swarazore23/Swara_Zore/Project Documents/4. Learnings & Reflections_SwaraZore.pdf

# Learnings & Reflections Document

### 1. Team Reflection

The team worked well because we balanced each other. One person brought optimism and energy, while the other brought practicality and structure. At different moments, one took the lead while the other supported. Consistent effort from both sides helped the project move forward. What worked well was our natural division of tasks, regular communication, and ability to support each other during stressful moments. We stayed committed and kept working steadily.
Better emotional handling could improve teamwork. If one person panicked, the other often had to carry more pressure. Managing stress better would make the process smoother for both members.

### 2. Technical Reflection

Loose wire connections were one of the biggest challenges, as they repeatedly caused circuits to stop working. Sensors and components also needed multiple rounds of testing before working properly.
I learned the importance of neat wiring, careful testing, and building systems step by step. I also understood how small coding errors can affect the whole project.
We often had to redo circuits and test components individually to find faults. Repeating tests, correcting errors, and improving the code taught us patience and problem-solving.

### 3. Design Reflection

The final outcome was fairly close to our original idea. Although some features were simplified due to time and material limits, it still delivered the intended escape room experience.
With more time, I would improve the finishing, hide wires better, add smoother mechanisms, and make the puzzles more immersive and refined.

### 4. Personal Reflection

I learned that patience and consistency are the keys to completing any project. Progress felt slow many times, but showing up regularly and continuing to work made all the difference. I also realized that small victories feel the most special when they come after a lot of effort. Another important lesson was understanding how team dynamics can either strengthen a project or weaken it. I also understood the fine line between optimism and delusion. It is important to stay hopeful, but being practical matters just as much.

I struggled with recurring technical issues, including loose wiring, code errors, and components failing during testing. Managing time pressure while maintaining quality was also difficult. At times, balancing ambitious ideas with realistic execution was a challenge.

I am proud that we stayed committed despite setbacks and completed a functional, interactive escape room model. I am also proud that we were able to combine storytelling, electronics, puzzles, and teamwork into one final experience.
