swarazore23/Swara_Zore/Software Details/Software Details_EscapeRoom.pdf

# Software Documentation

### 1. Software Overview

What does the software do?

The escape room software runs entirely on two ESP32 microcontrollers using MicroPython. There is no mobile app or external communication involved. Each ESP32 independently manages its puzzle logic — reading sensor inputs, controlling LEDs, operating a servo motor, and triggering a buzzer. When a player completes the puzzle correctly, the system gives a visual and/or audio confirmation.

- Room 1 has its own dedicated ESP32. It detects whether a wire is correctly connected and waits for the player to press a button to confirm the puzzle is solved. LEDs provide feedback throughout.
- Rooms 2 and 3 share a single ESP32 and run the same code. The player must trigger a scan input followed by an IR sensor. This opens a servo-controlled door, starts a blinking alarm, and waits for the player to press a stop button to complete the puzzle.

Platforms used:

- MicroPython (programming language for ESP32)
- 2x ESP32 microcontrollers (one for Room 1, one shared by Room 2 & 3)
- Thonny IDE (used to write and upload code)
- No app, no Bluetooth, no Wi-Fi — fully offline and local

### 2. System Logic

Room 1 — Wire Detection Puzzle (ESP32 #1)

1. ESP32 powers on — yellow LED turns on to show system is ready
2. System continuously checks the wire input pin
3. Player connects the correct wire
4. Wire input pin goes HIGH — all three LEDs (led1, led2, led3) turn on

5. Player presses the button
6. Button pin goes LOW — green LED (ledG) turns on, confirming puzzle solved
7. System continues running (LEDs stay on)

Room 2 & 3 — Scan, IR & Servo Puzzle (ESP32 #2, shared)

1. ESP32 powers on — led1 turns on to show system is ready
2. System continuously checks the scan input pin
3. Player performs the scan action (triggers scan input HIGH)
4. led2 and led3 turn on — scan confirmed
5. System now waits for IR sensor to be triggered
6. Player moves in front of the IR sensor (IR pin goes LOW)
7. Servo opens (duty = 40) — door unlocks
8. Alarm loop starts — led4 and buzzer blink repeatedly
9. After 15 seconds — servo automatically closes (duty = 115)
10. Player presses the stop button
11. Buzzer turns off, led1 turns off, green LED turns on — puzzle solved

### 3. Flowchart

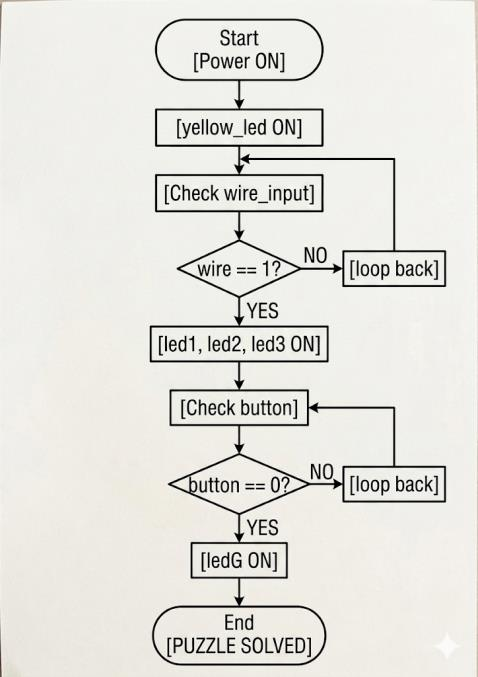
[picture p7: figure]
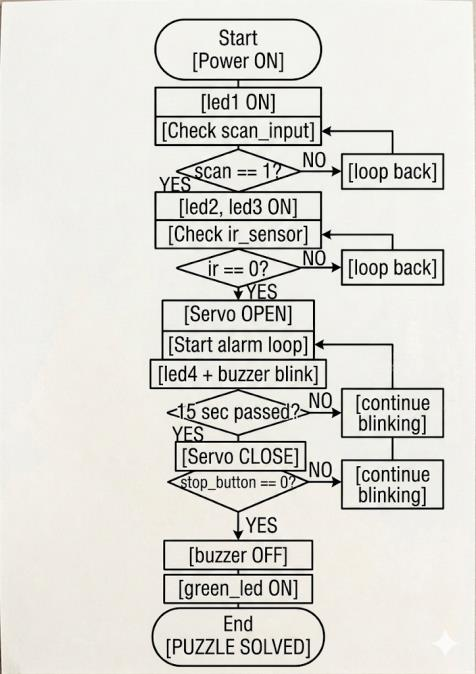
[picture p8: figure]

Room 1 - | Room 2-
