swarazore23/Swara_Zore/Software Details/final codes with versions_EscapeRoom.pdf

Room 1 -Version 1 — Basic Prototype

Goal of this version: Get the core logic working — detect the wire, light an LED, detect the button press. No concern for noise or stability yet.

This was our very first attempt. We set up the minimum number of pins needed and got the logic running in a tight while loop. At this stage we did not use pull-up resistors, which later turned out to be a problem.

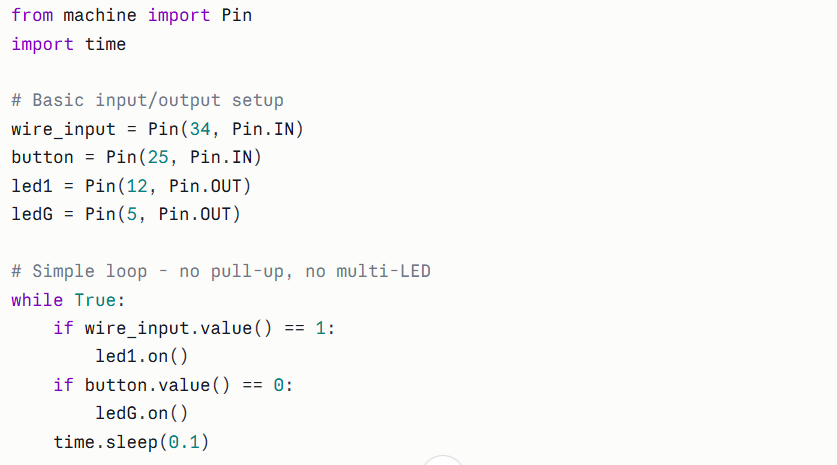
[picture p9: figure]

Problems noticed: Without PULL_UP resistors, the input pins picked up floating noise. The wire_input would randomly trigger even with nothing connected. We also only had one LED, giving very little visual feedback to the player.

Version 2 — Intermediate Improvements

Goal of this version: Added Pin.PULL_UP to both inputs to eliminate floating signal noise. Expanded to 3 wire-trigger LEDs and added a yellow 'system on' LED.

After testing Version 1, the wire input was randomly triggering due to floating voltage on the pin. We added internal pull-up resistors, which solved this immediately. We also added more LEDs so the puzzle had a clearer visual response — three LEDs lighting up together is much more satisfying for the player than just one.

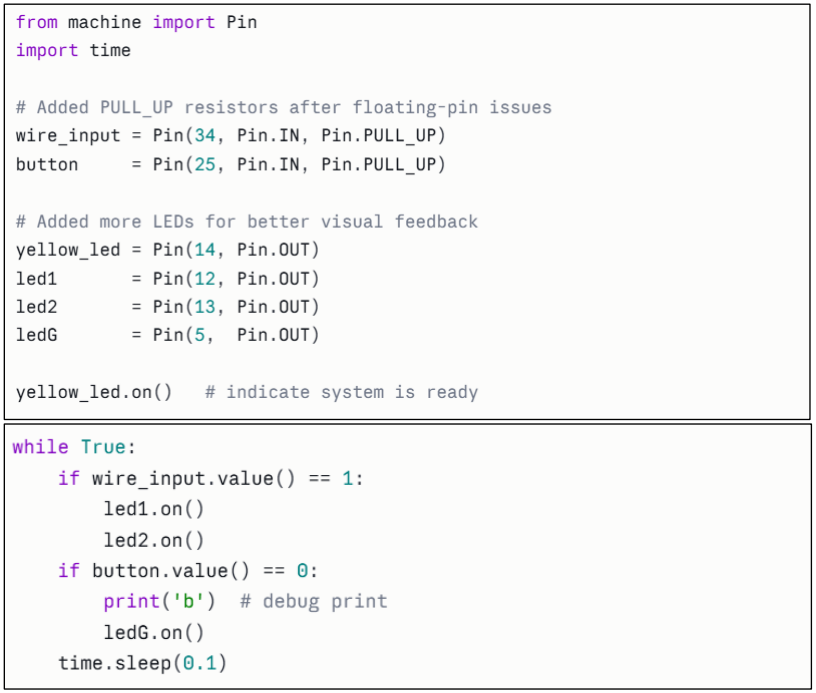
[picture p10: figure]

What improved: Stable input readings. Three LEDs gave better visual feedback. The yellow LED clearly shows the system is powered and ready. Debug print was added to confirm button presses over serial.

Final Version — Complete Room 1 System

Final state: Clean, commented, production-ready code. Added led3 (Pin 27) to the wire detection group. All pins initialized explicitly at startup.

The final version added a third wire-detection LED (led3 on pin 27) to give the full three-LED effect. We also cleaned up all the code, added section comments, and ensured every pin is initialized to a known state at startup. This prevents LEDs being stuck on from a previous run or power cycle.

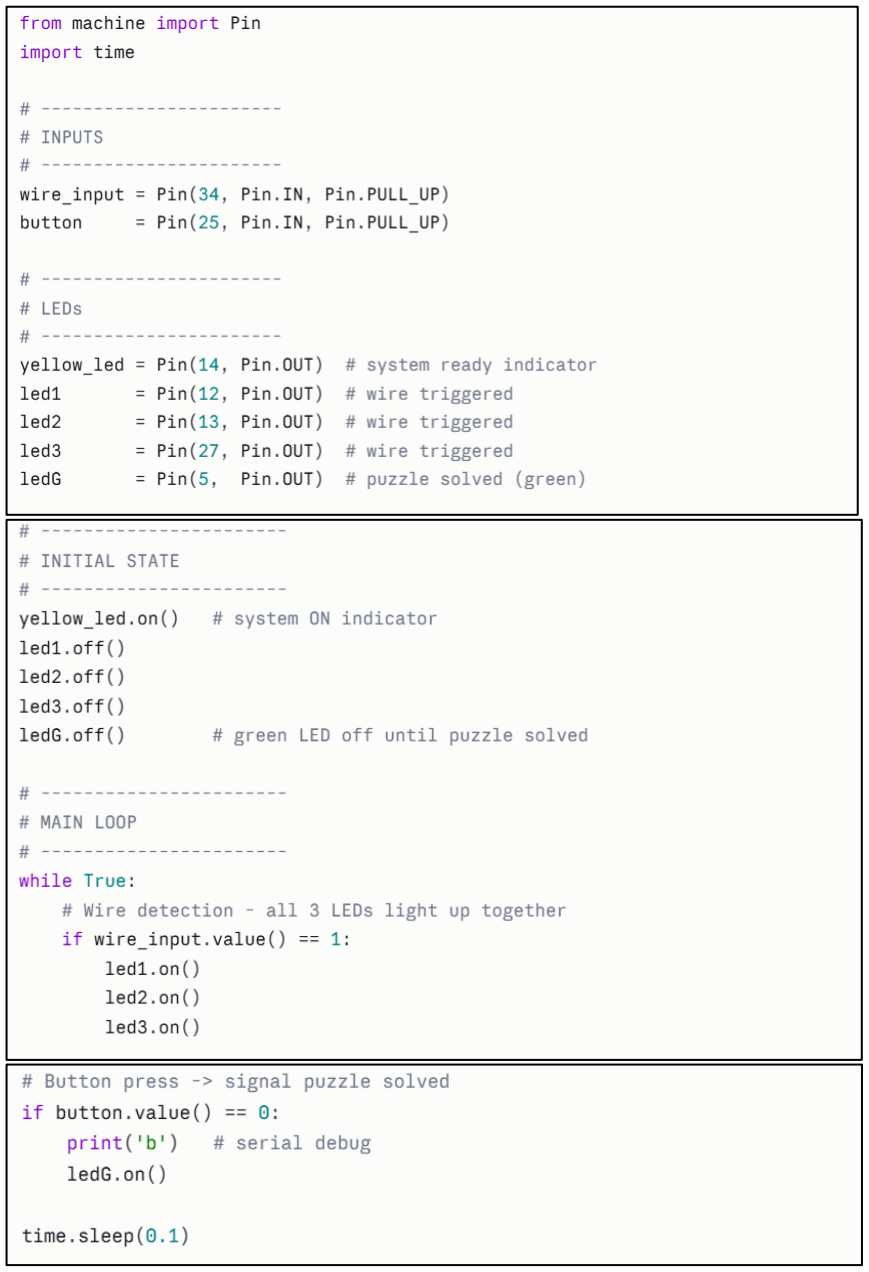
[picture p11: figure]

Room 2 & Room 3

Rooms 2 and 3 share the same code. The puzzle requires a player to scan an input (simulating an RFID / card reader), which then waits for an IR sensor to detect the player's action. A servo motor acts as a door lock that opens automatically, closes after 15 seconds, and a buzzer + LED alarm runs until the player presses a stop button.

Version 1 — Basic Prototype

Goal of this version: Prove that the scan input can be detected and trigger a buzzer. Servo and IR sensor not added yet.

We started with just the scan input and buzzer — the simplest possible version to verify our wiring and input detection were correct. The buzzer simply turned on and off on a fixed delay with no interactive element.

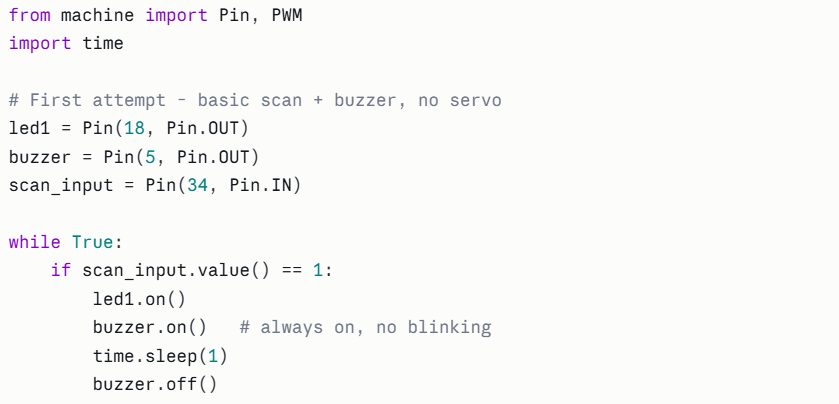
[picture p12: figure]

Problems noticed: The buzzer had no blinking — it just stayed on, which was too harsh. There was no way for a player to stop the alarm. The servo and IR sensor weren't integrated yet, so the 'door open' mechanic did not exist.

Version 2 — Intermediate: Servo + IR Added

Goal of this version: Integrated the servo motor with a PWM signal. Added the IR sensor as a second trigger. Alarm now blinks properly. Auto-close added for the servo.

In this version we introduced the servo motor. Calibrating the duty cycle values took several tries — we tested values between 25 and 130 before settling on 40 (open) and 115 (closed) as the correct positions for our mounting angle. The IR sensor was added as a second step in the puzzle flow, and the alarm loop was improved to properly blink the LED and buzzer instead of just toggling once.

We also introduced a 15-second auto-close timer using time.time(), which gives players a window to step through before the door re-locks.

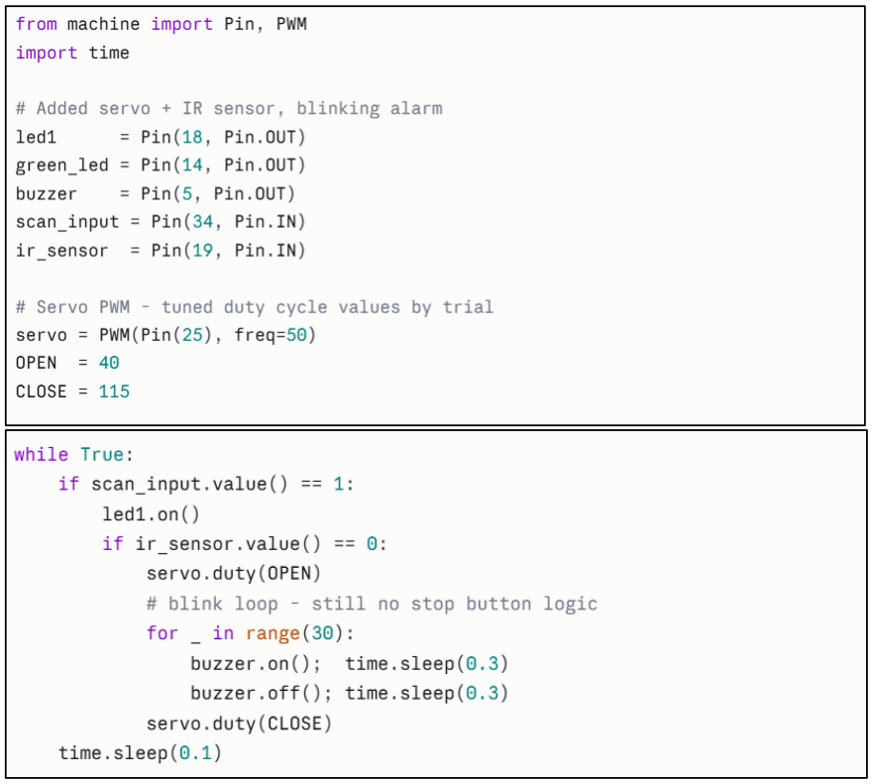
[picture p13: figure]

Remaining issues: The stop_button pin did not have PULL_UP configured — we found it would sometimes trigger randomly. There was also no way to cleanly exit the inner while loops, which made the logic harder to trace.

Final Version — Complete Room 2 & 3 System

Final state: Full multi-step puzzle with 5 LEDs, buzzer, servo, IR sensor, scan input, and stop button. PULL_UP added to stop_button. Clean nested loop logic with clear print statements for debugging.

The final version brings all components together into a complete, production-ready system. Key changes from v2 include adding Pin.PULL_UP to the stop_button (which fixed the random triggering), expanding from 2 to 5 LEDs for richer visual feedback, clearly separating each step with comments, and ensuring the buzzer is explicitly turned off before the green LED turns on.

We also added led4 as a dedicated alarm LED that blinks in sync with the buzzer, making the alert state visually obvious to players.

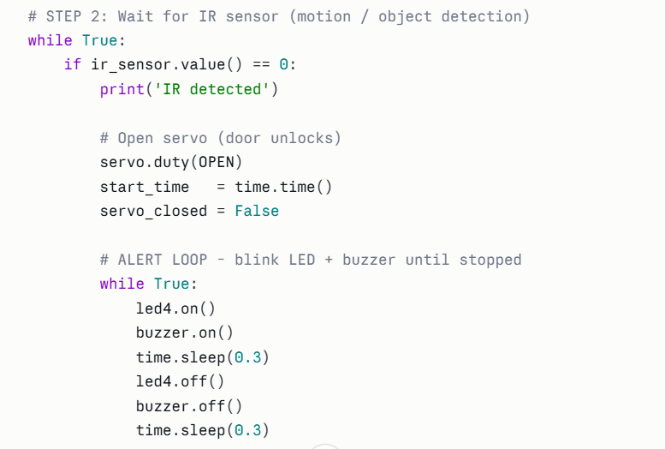
[picture p14: figure]
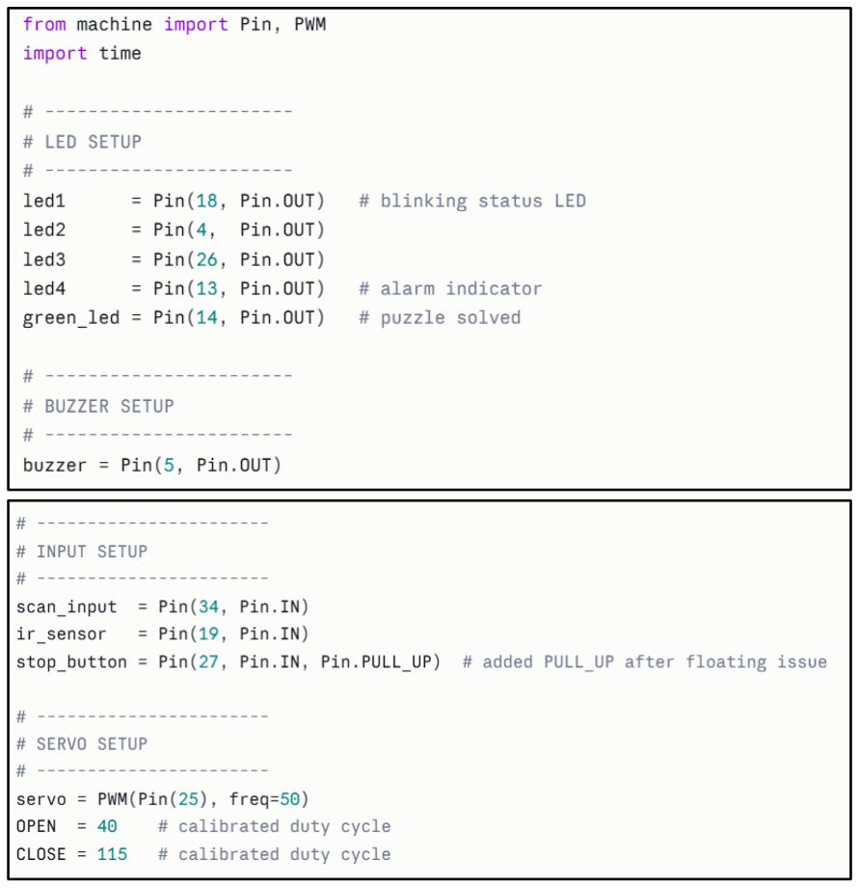
[picture p15: figure]
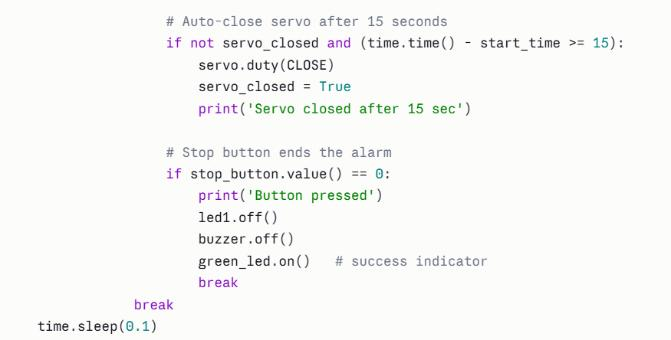
[picture p16: figure]
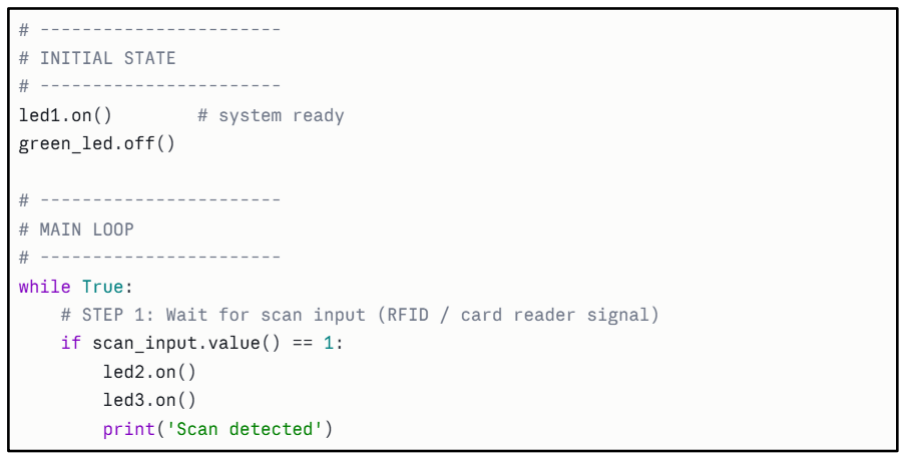
[picture p17: figure]
