swarazore23/Swara_Zore/Media/Week1/Media_week01_EscapeRoom.pdf

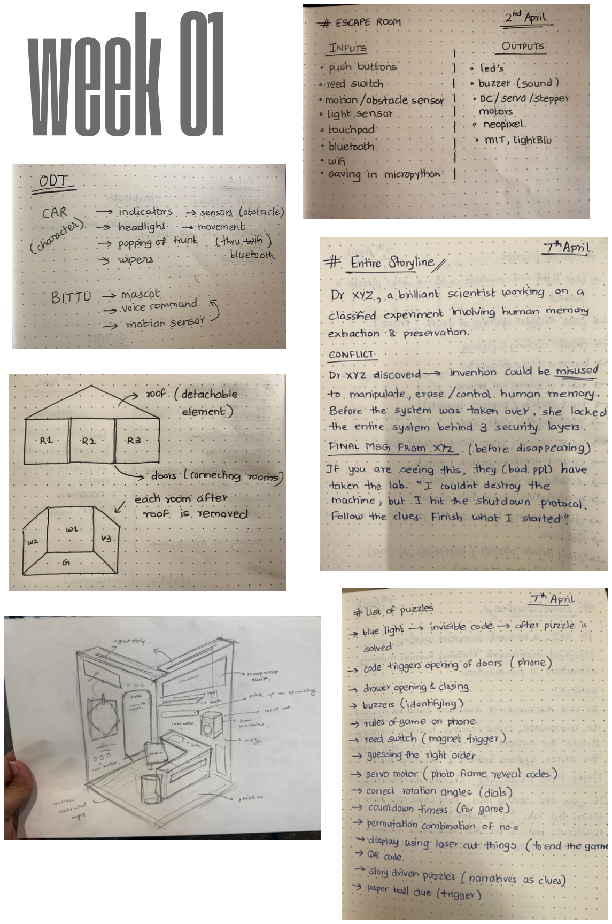
[picture p18: page 1]

week 01

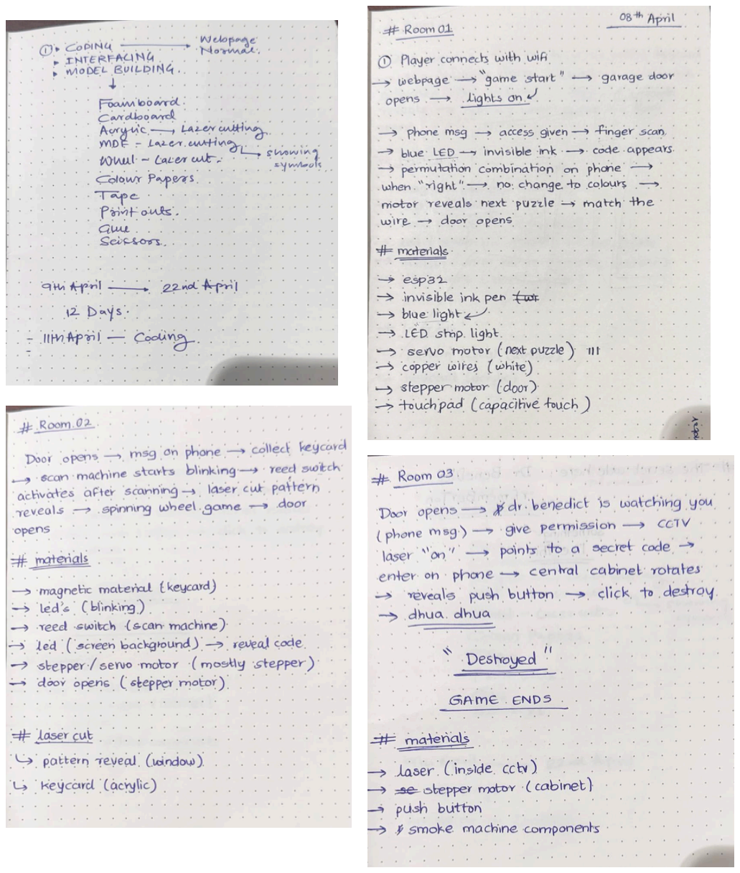
[picture p19: page 2]
