swarazore23/Swara_Zore/Mechanical Details/LASERCUT_EscapeRoom.dxf

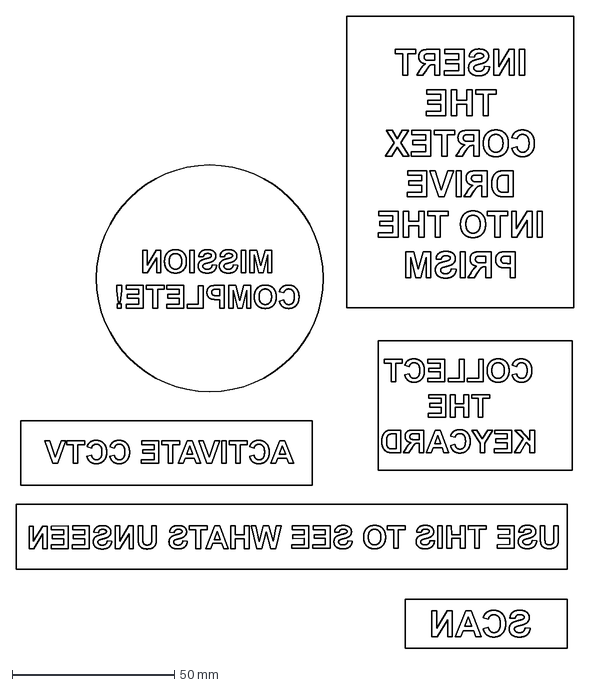
[picture p20: CAD file, 2026-04-21]
Mechanical Details/LASERCUT_EscapeRoom.dxf
172.0 x 195.0 mm
